joshingyou/BRAKE/README.md

# BRAKE
Introducing BRAKE: an integrated safety system designed for everyday bikers.
