joshingyou/BRAKE/Android/README.md

# BRAKE/Android
This is where the code for the Android companion app lives.
