joshingyou/BRAKE/Arduino/README.md

# BRAKE/Arduino
This is where all Arduinos and/or custom micro-controller boards' driver and 
firmware code lives.
