joshingyou/BRAKE/Eagle/README.md

# BRAKE/Eagle
This is where the Eagle PCB design files live.
