joshingyou/BRAKE/Documentations/Bluetooth_Message_Definitions.PNG

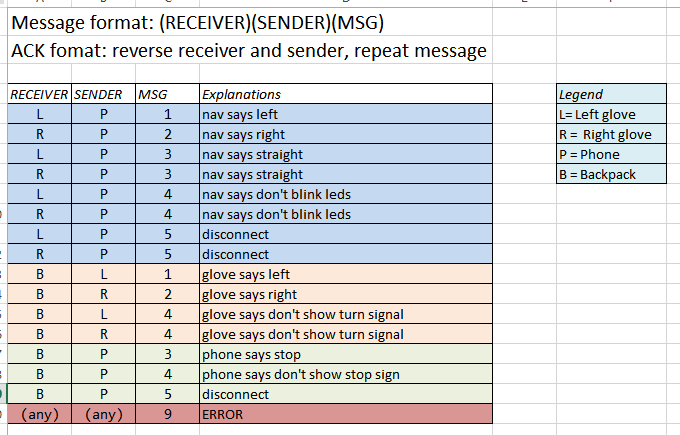
Documentations/Bluetooth_Message_Definitions.PNG
