joshingyou/BRAKE/(threads)

Thread 1 (2015-03-30):

missing part for the gloves

jihyel, 2015-03-30:
The C code is programmed under the assumption that it will receive sensor values from
5 flex sensors & gyros(x,y,z) values from "MPU-6050".
Can anyone put "MPU-6050" on order list?
