joshingyou/BRAKE/Eagle/GloveLeft/Left_Glove.brd

## EAGLE design Eagle/GloveLeft/Left_Glove.brd (2015-04-26)

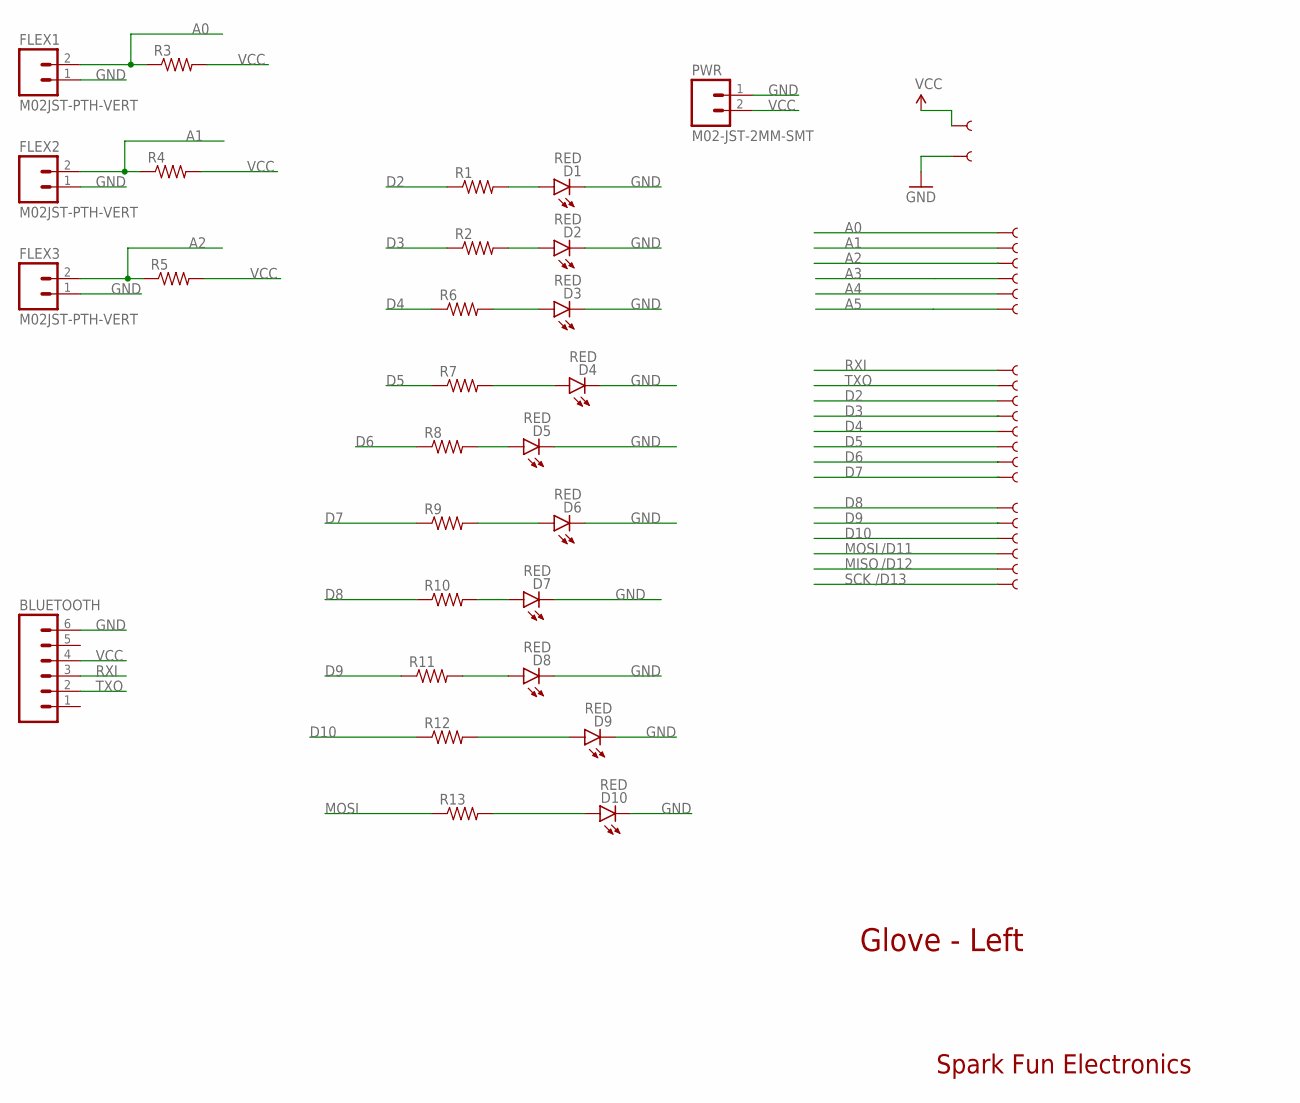
[picture p11: schematic Left_Glove.sch]

Parts:
BLUETOOTH: M06LOCK; 1X06_LOCK
D1, D2, D3, D4, D5, D6, D7, D8, D9, D10: RED; LED-1206
FLEX1, FLEX2, FLEX3: M02JST-PTH-VERT; JST-2-PTH-VERT
PWR: M02-JST-2MM-SMT; JST-2-SMD
R1, R2, R3, R4, R5, R6, R7, R8, R9, R10, R11, R12, R13: RESISTOR1206; 1206
U$22, U$23, U$24, U$26, U$27, U$28, U$29, U$30, U$31, U$32, U$33, U$34, U$35, U$36, U$37, U$38, U$39, U$40, U$41, U$42, U$43, U$44: SEWTAP1; PETAL-LONG-1

Connections:
A0: FLEX1.2, R3.1, U$24.P$1
A1: FLEX2.2, R4.1, U$26.P$1
A2: FLEX3.2, R5.1, U$27.P$1
A3: U$28.P$1
A4: U$29.P$1
A5: U$30.P$1
D2: R1.1, U$33.P$1
D3: R2.1, U$34.P$1
D4: R6.1, U$35.P$1
D5: R7.1, U$36.P$1
D6: R8.1, U$37.P$1
D7: R9.1, U$38.P$1
D8: R10.1, U$39.P$1
D9: R11.1, U$40.P$1
D10: R12.1, U$41.P$1
GND: BLUETOOTH.6, D1.C, D2.C, D3.C, D4.C, D5.C, D6.C, D7.C, D8.C, D9.C, D10.C, FLEX1.1, FLEX2.1, FLEX3.1, PWR.1 (2), U$23.P$1
MISO: U$43.P$1
MOSI: R13.1, U$42.P$1
unnamed: D10.A, R13.2
unnamed: D2.A, R2.2
unnamed: D1.A, R1.2
unnamed: D3.A, R6.2
unnamed: D4.A, R7.2
unnamed: D5.A, R8.2
unnamed: D6.A, R9.2
unnamed: D7.A, R10.2
unnamed: D8.A, R11.2
unnamed: D9.A, R12.2
RXI: BLUETOOTH.3, U$31.P$1
SCK: U$44.P$1
TXO: BLUETOOTH.2, U$32.P$1
VCC: BLUETOOTH.4, PWR.2 (1), R3.2, R4.2, R5.2, U$22.P$1

Notes on the sheet:
Glove - Left
Spark Fun Electronics
/D11
/D12
/D13

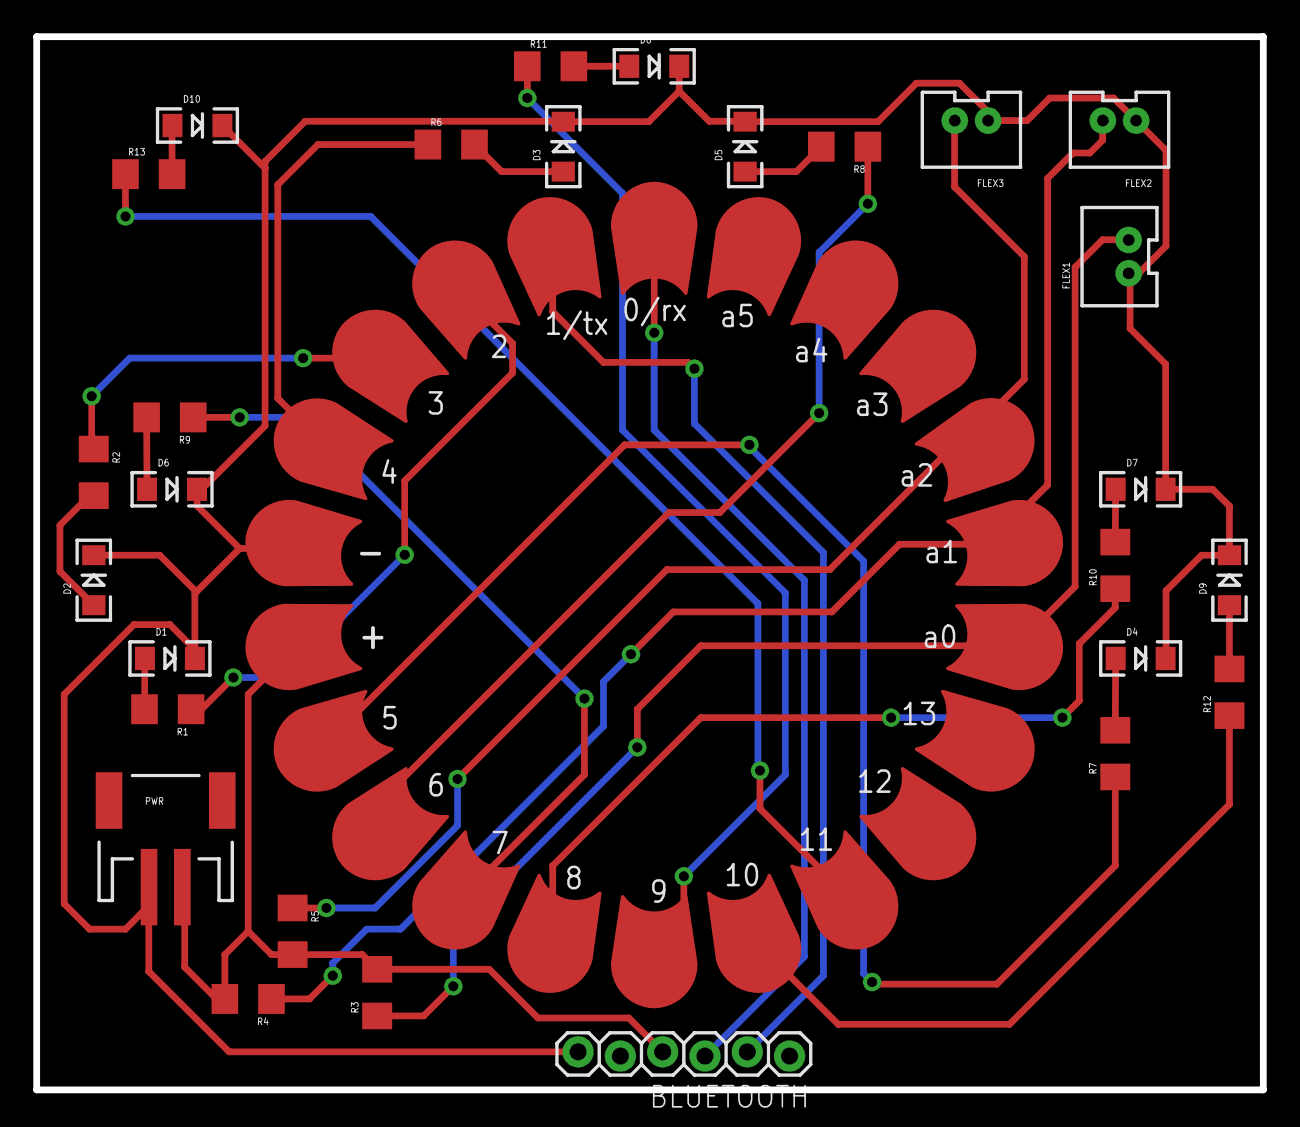
[picture p12: board Left_Glove.brd from above]

Board: 2 copper layers, 73.7 x 63.2 mm, 50 parts (0 on the bottom side), 27 nets.
