joshingyou/BRAKE/Eagle/Backpack-PCB/Backpack_Panel.brd

## EAGLE design Eagle/Backpack-PCB/Backpack_Panel.brd (2015-04-26)

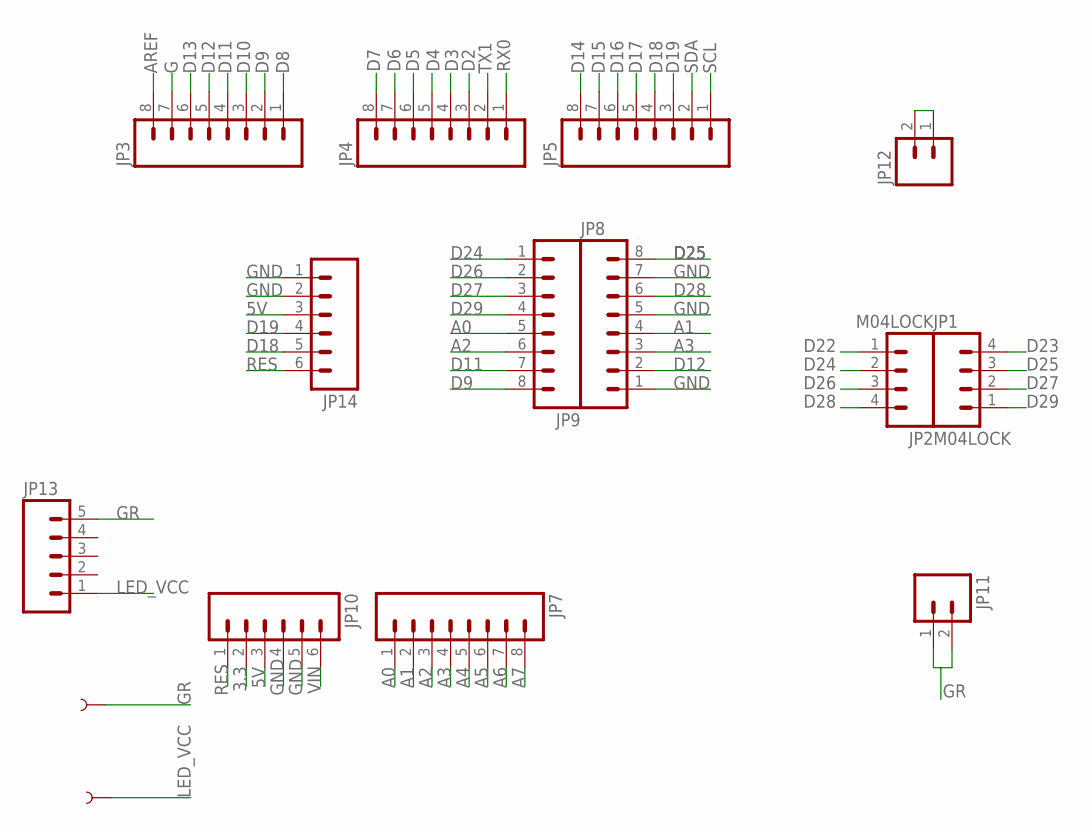
[picture p13: schematic Backpack_Panel.sch]

Parts:
JP1, JP2: M04LOCK; 1X04_LOCK
JP3, JP4, JP5, JP7, JP8, JP9: M08LOCK; 1X08_LOCK
JP10, JP14: M06LOCK; 1X06_LOCK
JP11, JP12: M02LOCK; 1X02_LOCK
JP13: M05LOCK; 1X05_LOCK
U$1, U$2: SEWTAP2; PETAL-LONG-2

Connections:
3.3: JP10.2
5V: JP10.3, JP14.3
A0: JP7.1, JP9.5
A1: JP7.2, JP8.4
A2: JP7.3, JP9.6
A3: JP7.4, JP8.3
A4: JP7.5
A5: JP7.6
A6: JP7.7
A7: JP7.8
AREF: JP3.8
D2: JP4.3
D3: JP4.4
D4: JP4.5
D5: JP4.6
D6: JP4.7
D7: JP4.8
D8: JP3.1
D9: JP3.2, JP9.8
D10: JP3.3
D11: JP3.4, JP9.7
D12: JP3.5, JP8.2
D13: JP3.6
D14: JP5.8
D15: JP5.7
D16: JP5.6
D17: JP5.5
D18: JP5.4, JP14.5
D19: JP5.3, JP14.4
D22: JP2.1
D23: JP1.4
D24: JP2.2, JP9.1
D25: JP1.3, JP8.8
D26: JP2.3, JP9.2
D27: JP1.2, JP9.3
D28: JP2.4, JP8.6
D29: JP1.1, JP9.4
G: JP3.7
GND: JP8.1, JP8.5, JP8.7, JP10.4, JP10.5, JP14.1, JP14.2
GR: JP11.1, JP11.2, JP13.5, U$1.1
LED_VCC: JP13.1, U$2.1
unnamed: JP12.1, JP12.2
RES: JP10.1, JP14.6
RX0: JP4.1
SCL: JP5.1
SDA: JP5.2
TX1: JP4.2
VIN: JP10.6

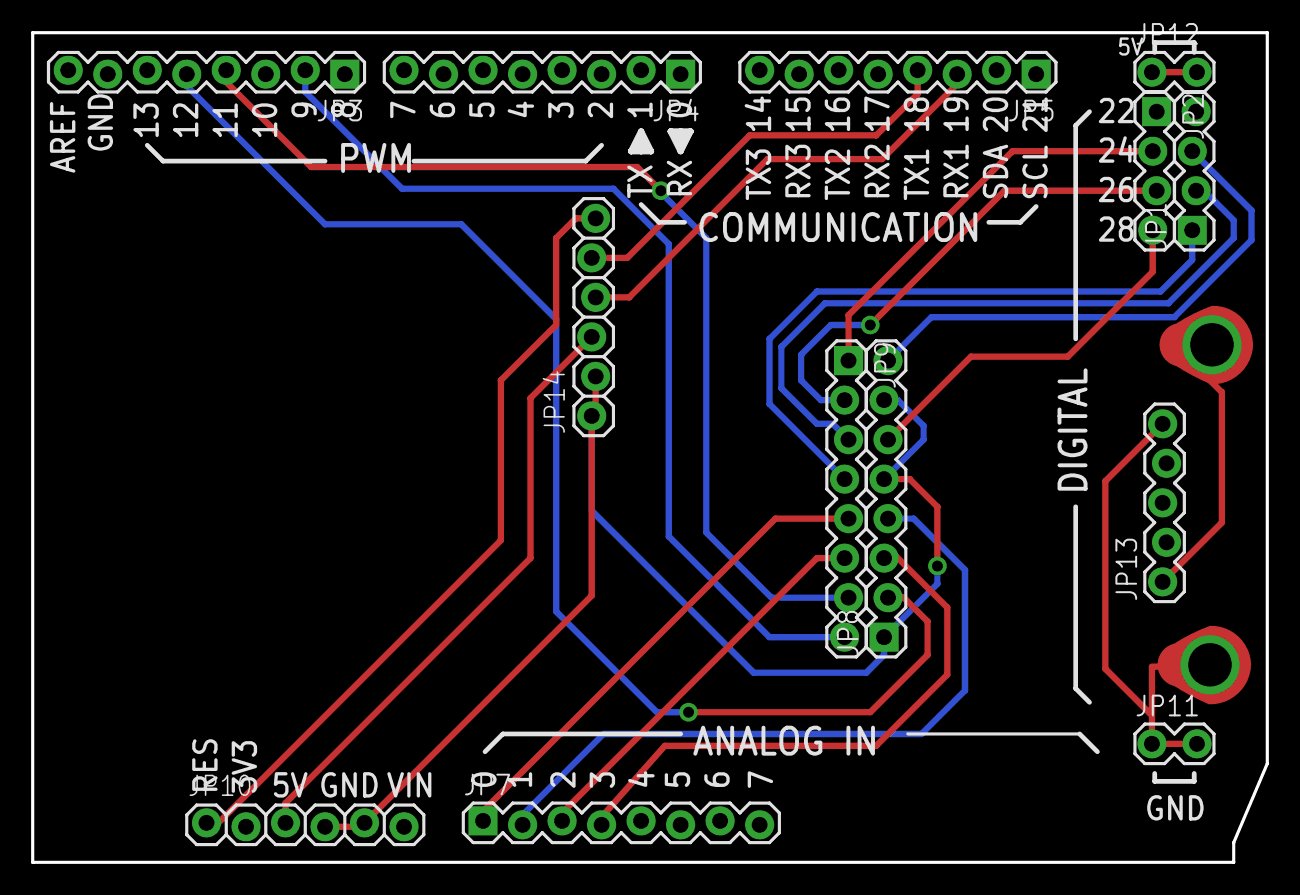
[picture p14: board Backpack_Panel.brd from above]

Board: 2 copper layers, 79.4 x 53.3 mm, 15 parts (0 on the bottom side), 21 nets.
