joshingyou/BRAKE/Arduino/BackpackLED/BackpackLED/src/main.cpp

/*
  main.cpp - Main loop for Arduino sketches
  Copyright (c) 2005-2013 Arduino Team.  All right reserved.

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
  You should have received a copy of the GNU Lesser General Public
  License along with this library; if not, write to the Free Software
  Foundation, Inc., 51 Franklin St, Fifth Floor, Boston, MA  02110-1301  USA
*/

#include "../lib/Arduino/Arduino.h"
#include "BackpackLED.h"

//Declared weak in Arduino.h to allow user redefinitions.
int atexit(void (*func)()) { return 0; }

// Weak empty variant initialization function.
// May be redefined by variant files.
void initVariant() __attribute__((weak));
void initVariant() { }

int main(void)
{
	init();

	initVariant();

#if defined(USBCON)
	USBDevice.attach();
#endif
	
	setup();
    
	for (;;) {
		loop();
		if (serialEventRun) serialEventRun();
	}
        
	return 0;
}
