joshingyou/BRAKE/python_script/Arduino_Monitor.py

" Warning: Needs to change port in each time. " 
" The following code was tested only on mac OS" 
    
from threading import Thread
import time
import serial

last_received = ''
def receiving(ser):
    global last_received
    buffer = ''
    while True:
        buffer = buffer + ser.read(ser.inWaiting())
        if '\n' in buffer:
            lines = buffer.split('\n') 
            last_received = lines[-2]
            buffer = lines[-1]


class SerialData(object):
    def __init__(self, init=50):
        try:
            self.ser = ser = serial.Serial(
                port='/dev/tty.usbmodem1411',
                baudrate=9600,
                bytesize=serial.EIGHTBITS,
                parity=serial.PARITY_NONE,
                stopbits=serial.STOPBITS_ONE,
                timeout=0.1,
                xonxoff=0,
                rtscts=0,
                interCharTimeout=None
            )
        except serial.serialutil.SerialException:
            #no serial connection
            self.ser = None
        else:
            Thread(target=receiving, args=(self.ser,)).start()
        
    def next(self):
        if not self.ser:
            return 100 
        for i in range(40):
            raw_line = last_received
            try:
                return float(raw_line.strip())
            except ValueError:
                print 'ERROR',raw_line
                time.sleep(.005)
        return 0.
    def __del__(self):
        if self.ser:
            self.ser.close()

if __name__=='__main__':
    s = SerialData()
    for i in range(500):
        time.sleep(.015)
        print s.next()
