joshingyou/BRAKE/(commit log)

2015-02-23 Created folders for different sub-systems
    Created folders for the Android app, the Arduino firmware and driver
    code, and Eagle PCB design files.
2015-03-18 SensorGloves C++ project was set up
    SensorGloves C++ project was set up
2015-03-18 Updated SensorGloves Atmel Studio project file
2015-04-05 LED panel code so far
2015-04-05 arduino libraries
2015-04-06 Updated Backpack Arduino code and added Gloves arduino code (NOT TESTED)
    1. Added code that enables backpack arduino as Bluetooth Central and
    gloves arduino as Bluetooth Peripheral.
    2. Backpack should search for peripherals and connect to them.
    3. Once connected, backpack would send a special string "18549Team16"
    over and
    the glove would light up the onboard LED.
    4. And then the glove would forever send 1, 2 and 3 over bluetooth.
2015-04-06 Attempted bug fixes for arduino code
    Communication only works from central to peripheral but not the other
    way.
    [BackpackLED549.ino, Gloves.ino]
2015-04-12 Created new Atmel Studio project for backpack led
    Also updated gitignore file to ignore DS_Store files
2015-04-14 Testing the basic environment setup. Keep giving me the error timeout
    [main.c]
2015-04-15 added Sensor reading code and mapping.
2015-04-20 Automatic calibration
2015-04-20 fixed the map bug
    [Gesture.ino]
2015-04-26 Updated most code in C/C++ outside of Arduino IDE
    SensorGloves and BackpackLED both compile. Need to add code related to
    different packets coming in and out. Need to add interrupts.
    [Backpack_Panel.brd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]
2015-04-27 Fixed init().
    Added main.cpp so that we can write setup() and loop() functions like
    Arduino
    [SensorGloves.cpp, blink_leds.c, blink_leds.h, main.cpp]
2015-04-28 Messed with Serial code. Doesn't work...
    [SensorGloves.cpp, blink_leds.c, blink_leds.h]
2015-04-29 Backpack and sensor gloves bluetooth working.
    Need to work on sending ack back.
2015-05-03 Relatively stable arduino code. Can send and receive from phone and backpack
    [Bluetooth_Message_Definitions.xlsx]
